deltaclo/SHT85-LOCIE/README.md

# SHT85-LOCIE
 
Acquisition cards for 16 SHT85 sensors.

Seiral Commands :

    READ?
    CONFIG?
    STATUS?
    *RST
    SET SHT1=
    SET SHT2=
    SET SHT3=
    SET SHT4=
    SET SHT5=
    SET SHT6=
    SET SHT7=
    SET SHT8=
    SET SHT9=
    SET SHT10=
    SET SHT11=
    SET SHT12=
    SET SHT13=
    SET SHT14=
    SET SHT15=
    SET SHT16=
    SET READ=
    SET MUX=
    SET BOXNAME=
    SET BOXIP=
    SET BOXGW=
    SET BOXMASK=
    SET BOXMAC=
    SET BOXNETWORK=
    GET SHT1
    GET SHT2
    GET SHT3
    GET SHT4
    GET SHT5
    GET SHT6
    GET SHT7
    GET SHT8
    GET SHT9
    GET SHT10
    GET SHT11
    GET SHT12
    GET SHT13
    GET SHT14
    GET SHT15
    GET SHT16
    GET READ
    GET MUX
    GET BOXNAME
    GET BOXIP
    GET BOXGW
    GET BOXMASK
    GET BOXMAC
    GET BOXNETWORK

  TCP/IP Commands:
  
    GET /config
    GET /read
    GET /status
    GET /rst
