deltaclo/SHT85-LOCIE/Documentation/images/ESP32-SHT85 3D - TF.png

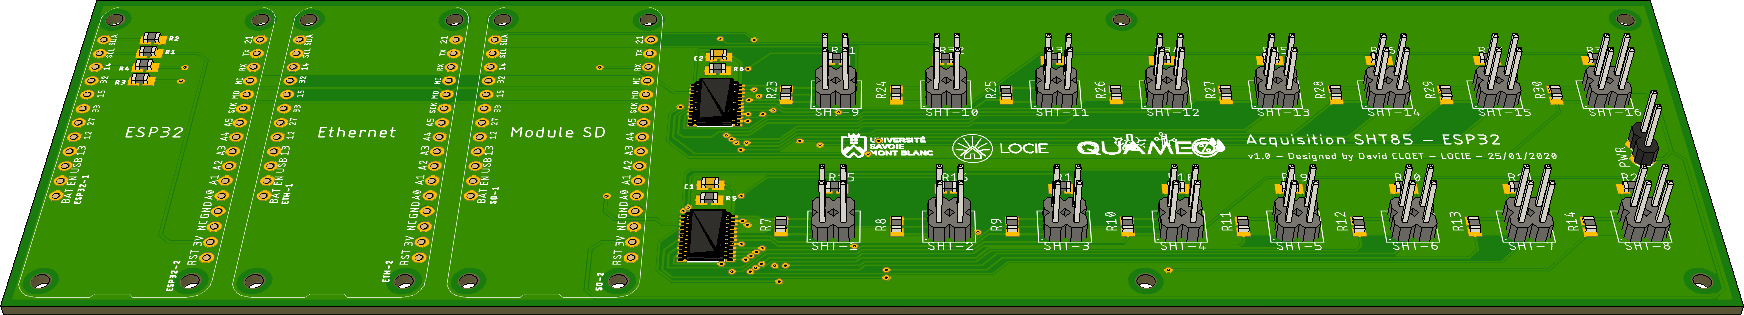
Documentation/images/ESP32-SHT85 3D - TF.png
