deltaclo/SHT85-LOCIE/PCB/ESP32_SHT85/sch/ESP32-SHT85_Page_1.png

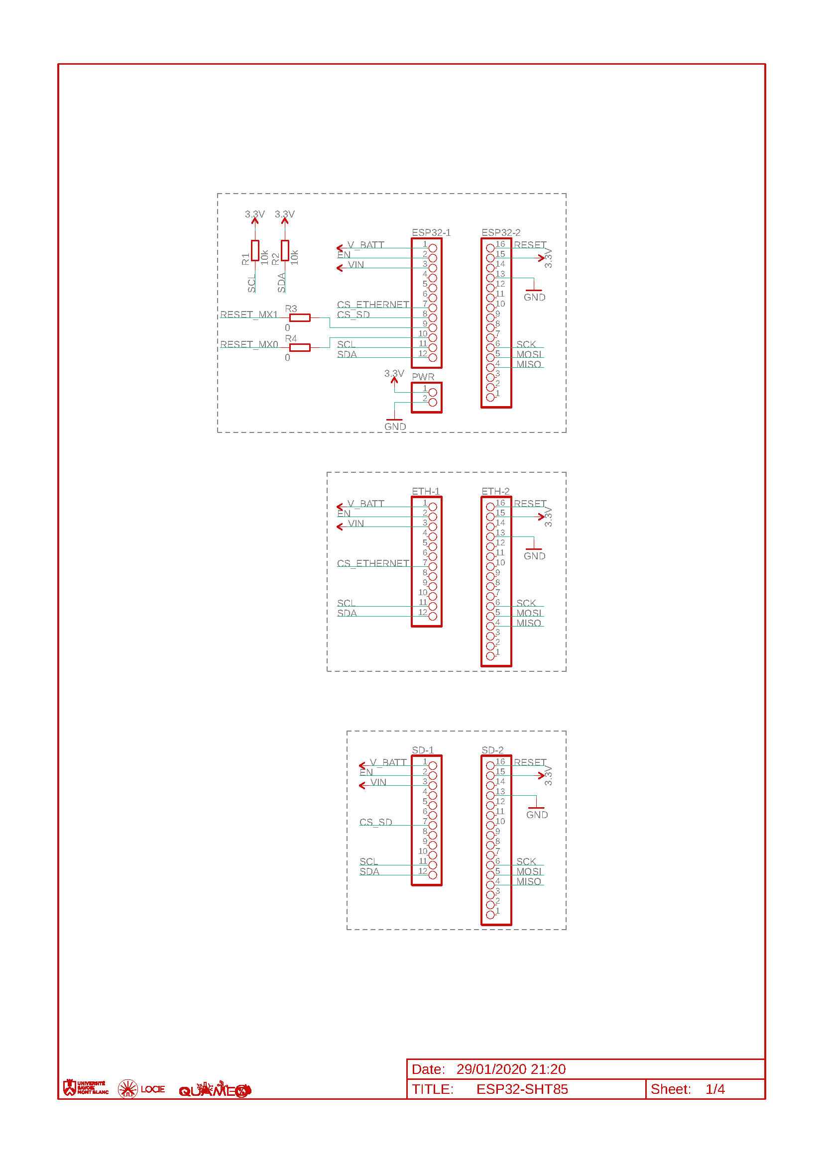
PCB/ESP32_SHT85/sch/ESP32-SHT85_Page_1.png
