deltaclo/SHT85-LOCIE/Documentation/ESP32-SHT85_BOM.xlsx

Sheet: BOM
Qty | Value | Device | Package | Fabricant | Parts | Description | Mouser | RS | Digikey | Farnell | Adafruit | Gotronic
1 | Adafruit 3405 | Adafruit 3405 | Feather Board | Adafruit | ESP32-1, ESP32-2 | Outils de développement Wi-Fi (802.11) HUZZAH32 - ESP32 Feather Board | Disponible | Non Disponible | Non Disponible | Non Disponible | Disponible | Disponible
1 | Adafruit 3201 | Adafruit 3201 | Feather Board | Adafruit | ETHER-1, ETHER-2 | Outils de développement Ethernet Ethernet FeatherWing | Disponible | Non Disponible | Disponible | Non Disponible | Disponible | Disponible
1 | Adafruit 2922 | Adafruit 2922 | Feather Board | Adafruit | SD-1, SD-2 | Accessoires Adafruit Adalogger FeatherWing - RTC + SD Add-on For All Feather Boards | Disponible | Disponible | Disponible | Non Disponible | Disponible | Disponible
2 | TCA9548APWR | TCA9548APWR | TSSOP24 | Texas Instruments | U1, U2 | CI commutateur - Divers 8-Channel I2C Switch | Disponible | Non Disponible | Disponible | Disponible | Non Disponible | Non Disponible
2 | 0 | MCU08050Z0000ZP500 | R0805 | Vishay | R3, R4 | Résistances à couches minces - CMS Zero ohm Jumper | Disponible | Disponible | Disponible | Disponible | Non Disponible | Non Disponible
36 | 10k | TNPW080510K0BEEA | R0805 | Vishay | R1, R2, R5, R6, R7, R8, R9, R10, R11, R12, R13, R14, R15, R16, R17, R18, R19, R20, R21, R22, R23, R24, R25, R26, R27, R28, R29, R30, R31, R32, R33, R34, R35, R36, R37, R38 | Résistances à couches minces - CMS 10Kohms .1% 25ppm | Disponible | Disponible | Disponible | Disponible | Non Disponible | Non Disponible
2 | 10uF | VJ0805G106KXYTW1BC | C0805 | Vishay | C1, C2 | Condensateurs céramique multicouches MLCC - CMS 10uF 6.3volts 10% | Disponible | Disponible | Disponible | Disponible | Non Disponible | Non Disponible
16 | SHT85_2X02PINHEAD | TSW-102-07-T-D | 2X02 | Samtec | SHT-1, SHT-2, SHT-3, SHT-4, SHT-5, SHT-6, SHT-7, SHT-8, SHT-9, SHT-10, SHT-11, SHT-12, SHT-13, SHT-14, SHT-15, SHT-16 | CONN HEADER VERT 4POS 2.54MM | Disponible | Disponible | Disponible | Disponible | Non Disponible | Non Disponible
1 | PINHD-1X2 | PINHD-1X2 | 1X02 | Samtec | PWR | CONN HEADER VERT 2POS 2.54MM | Disponible | Disponible | Disponible | Disponible | Disponible | Disponible

Sheet: MOUSER
N° MOUSER | N° de fab. | Fabricant | Description | Qté. | Prix (EUR) | Ext. : (EUR)
485-3405 | 3405 | Adafruit | Outils de développement Wi-Fi (802.11) HUZZAH32 - ESP32 Feather Board | 1 | 17.96 € | 17.96 €
485-3201 | 3201 | Adafruit | Outils de développement Ethernet Ethernet FeatherWing | 1 | 17.96 € | 17.96 €
485-2922 | 2922 | Adafruit | Accessoires Adafruit Adalogger FeatherWing - RTC + SD Add-on For All Feather Boards | 1 | 8.06 € | 8.06 €
595-TCA9548APWR | TCA9548APWR | Texas Instruments | CI commutateur - Divers 8-Channel I2C Switch | 2 | 1.36 € | 2.72 €
594-MCU08050Z0000ZP5 | MCU08050Z0000ZP500 | Vishay | Résistances à couches minces - CMS Zero ohm Jumper | 2 | 0.20 € | 0.40 €
71-TNPW080510K0BEEA | TNPW080510K0BEEA | Vishay | Résistances à couches minces - CMS 10Kohms .1% 25ppm | 36 | 0.47 € | 16.85 €
77-VJ805G106KXYTW1BC | VJ0805G106KXYTW1BC | Vishay | Condensateurs céramique multicouches MLCC - CMS 10uF 6.3volts 10% | 2 | 0.27 € | 0.54 €
200-TSW10207TD | TSW-102-07-T-D | Samtec | Embases et logements de câbles .100" Terminal Strip | 16 | 0.20 € | 3.26 €
200-TSW10207TS | TSW-102-07-T-S | Samtec | Embases et logements de câbles .100" Terminal Strip | 1 | 0.12 € | 0.12 €
 |  |  |  |  | Total des articles : | 67.87 €

Sheet: RS
N° RS | N° de fab. | Fabricant | Description | Qté. | Prix (EUR) | Ext. : (EUR)
 | 3405 | Adafruit | Outils de développement Wi-Fi (802.11) HUZZAH32 - ESP32 Feather Board | 1 |  | 0.00 €
 | 3201 | Adafruit | Outils de développement Ethernet Ethernet FeatherWing | 1 |  | 0.00 €
124-5518 | 2922 | Adafruit | Accessoires Adafruit Adalogger FeatherWing - RTC + SD Add-on For All Feather Boards | 1 | 8.12 | 8.12 €
 | TCA9548APWR | Texas Instruments | CI commutateur - Divers 8-Channel I2C Switch | 2 |  | 0.00 €
188-5952 | MCU08050Z0000ZP500 | Vishay | Résistances à couches minces - CMS Zero ohm Jumper | 2 | 0.065 | 0.13 €
818-3131 | PATT0805E1002BGT5 | Vishay | Résistances à couches minces - CMS 10Kohms .1% 25ppm | 36 | 0.98 € | 35.21 €
172-1528 | JMK212ABJ106KD-T | Taiyo Yuden | Condensateurs céramique multicouches MLCC - CMS 10uF 6.3volts 10% | 2 | 0.059 | 0.12 €
155-8161 | TSW-102-07-T-D | Samtec | Embases et logements de câbles .100" Terminal Strip | 16 | 0.198 | 3.17 €
155-8169 | TSW-102-07-T-S | Samtec | Embases et logements de câbles .100" Terminal Strip | 1 | 0.10 € | 0.10 €
 |  |  |  |  | Total des articles : | 46.74 €

Sheet: DIGIKEY
N° DIGIKEY | N° de fab. | Fabricant | Description | Qté. | Prix (EUR) | Ext. : (EUR)
 | 3405 | Adafruit | Outils de développement Wi-Fi (802.11) HUZZAH32 - ESP32 Feather Board | 1 |  | 0.00 €
1528-1725-ND | 3201 | Adafruit | Outils de développement Ethernet Ethernet FeatherWing | 1 | 17.74 | 17.74 €
1528-1621-ND | 2922 | Adafruit | Accessoires Adafruit Adalogger FeatherWing - RTC + SD Add-on For All Feather Boards | 1 | 7.96 | 7.96 €
296-34905-1-ND | TCA9548APWR | Texas Instruments | CI commutateur - Divers 8-Channel I2C Switch | 2 | 1.33 | 2.66 €
MCU0805-0.0-ZZCT-ND | MCU08050Z0000ZP500 | Vishay | Résistances à couches minces - CMS Zero ohm Jumper | 2 | 0.38 | 0.76 €
TNP10.0KABCT-ND | TNPW080510K0BEEA | Vishay | Résistances à couches minces - CMS 10Kohms .1% 25ppm | 36 | 0.44 € | 15.91 €
720-1854-1-ND | VJ0805G106KXYTW1BC | Taiyo Yuden | Condensateurs céramique multicouches MLCC - CMS 10uF 6.3volts 10% | 2 | 0.25 | 0.50 €
SAM1034-02-ND | TSW-102-07-T-D | Samtec | Embases et logements de câbles .100" Terminal Strip | 16 | 0.23 | 3.68 €
SAM1035-02-ND | TSW-102-07-T-S | Samtec | Embases et logements de câbles .100" Terminal Strip | 1 | 0.16 € | 0.16 €
 |  |  |  |  | Total des articles : | 49.37 €

Sheet: FARNELL
N° FARNELL | N° de fab. | Fabricant | Description | Qté. | Prix (EUR) | Ext. : (EUR)
 | 3405 | Adafruit | Outils de développement Wi-Fi (802.11) HUZZAH32 - ESP32 Feather Board | 1 |  | 0.00 €
 | 3201 | Adafruit | Outils de développement Ethernet Ethernet FeatherWing | 1 |  | 0.00 €
 | 2922 | Adafruit | Accessoires Adafruit Adalogger FeatherWing - RTC + SD Add-on For All Feather Boards | 1 |  | 0.00 €
3124884 | TCA9548APWR | TEXAS INSTRUMENTS | CI commutateur - Divers 8-Channel I2C Switch | 2 | 1.32 | 2.64 €
2614475 | MCU08050Z0000ZP500 | VISHAY | Résistances à couches minces - CMS Zero ohm Jumper | 2 | 0.178 | 0.36 €
1653329 | TNPW080510K0BEEA | VISHAY | Résistances à couches minces - CMS 10Kohms .1% 25ppm | 36 | 0.61 € | 21.96 €
9227814 | C0805C106K9PACTU | KEMET | Condensateurs céramique multicouches MLCC - CMS 10uF 6.3volts 10% | 2 | 0.171 | 0.34 €
2984553 | TSW-102-07-T-D | SAMTEC | Embases et logements de câbles .100" Terminal Strip | 16 | 0.173 | 2.77 €
2505046 | TSW-102-07-T-S | Samtec | Embases et logements de câbles .100" Terminal Strip | 1 | 0.08 € | 0.08 €
 |  |  |  |  | Total des articles : | 28.15 €
