deltaclo/SHT85-LOCIE/Documentation/Panier/ESP32-SHT85_BOM_Farnell.xls

Line Number | Order Code | Manufacturer Name | Manufacturer Part Number | Description | Price | Availability | Quantity
1 | Adafruit 3405 |  |  | Outils de développement Wi-Fi (802.11) HUZZAH32 - ESP32 Feather Board
2 | Adafruit 3201 |  |  | Outils de développement Ethernet Ethernet FeatherWing
3 | Adafruit 2922 |  |  | Accessoires Adafruit Adalogger FeatherWing - RTC + SD Add-on For All Feather Boards
4 | 3124884 | TEXAS INSTRUMENTS | TCA9548APWR | TCA9548APWR-Interface spécialisée, I2C, SM Bus | 1+ €1.32 25+ €1.16 50+ €1.04 100+ €0.927 250+ €0.87 500+ €0.812 1000+ €0.626 2500+ €0.617 | 397 | 2
5 | 2614475 | VISHAY | MCU08050Z0000ZP500 | MCU08050Z0000ZP500-Résistance à puce CMS, 0805 [2012 Metric], 0 ohm, MCU 0805 Series, 150 V, Couche mince, 200 mW | 10+ €0.178 250+ €0.0925 1000+ €0.0705 5000+ €0.0553 10000+ €0.0545 20000+ €0.051 100000+ €0.0453 | 24258 | 2
6 | 1653329 | VISHAY | TNPW080510K0BEEA | TNPW080510K0BEEA-Résistance à puce CMS, Couche mince, 0805 [2012 Metric], 10 kohm, Série TNPW, 150 V, Couche mince | 10+ €0.61 100+ €0.308 500+ €0.244 1000+ €0.18 2500+ €0.178 5000+ €0.162 25000+ €0.16 | 11540 | 36
7 | 9227814 | KEMET | C0805C106K9PACTU | C0805C106K9PACTU-Condensateur céramique multicouche CMS, 10 µF, 6.3 V, 0805 [2012 Metric], ± 10%, X5R, Série C KEMET | 5+ €0.171 50+ €0.0939 250+ €0.0722 500+ €0.0626 1500+ €0.0458 | 15451 | 2
8 | 2984553 | SAMTEC | TSW-102-07-T-D | TSW-102-07-T-D-Connecteur carte-à-carte, 2.54 mm, 4 Contact(s), Embase, TSW Series, Traversant, 2 Rangée(s) | 10+ €0.173 100+ €0.15 500+ €0.143 1000+ €0.124 2500+ €0.112 5000+ €0.0991 | 532 | 16
