deltaclo/SHT85-LOCIE/Documentation/Panier/ESP32-SHT85_BOM_Mouser.xls

PANIER
Ceci n'est pas une facture
26-janv.-20 13:53:24
 | N° Mouser | N° de fab. | Fabricant | N° client | Description | RoHS | Cycle de vie | Qté. | Prix (EUR) | Ext. : (EUR)
1 | 71-TNPW080510K0BEEA | TNPW080510K0BEEA | Vishay |  | Résistances à couches minces - CMS 10Kohms .1% 25ppm | RoHS : conforme |  | 36 | 0,468 € | 16,85 €
2 | 485-3405 | 3405 | Adafruit |  | Outils de développement Wi-Fi (802.11) HUZZAH32 - ESP32 Feather Board | RoHS : conforme |  | 1 | 17,96 € | 17,96 €
3 | 485-3201 | 3201 | Adafruit |  | Outils de développement Ethernet Ethernet FeatherWing | RoHS : conforme |  | 1 | 17,96 € | 17,96 €
4 | 485-2922 | 2922 | Adafruit |  | Accessoires Adafruit Adalogger FeatherWing - RTC + SD Add-on For All Feather Boards | RoHS : conforme |  | 1 | 8,06 € | 8,06 €
5 | 200-TSW10207TD | TSW-102-07-T-D | Samtec |  | Embases et logements de câbles .100" Terminal Strip | RoHS : conforme | Nouveau chez Mouser | 16 | 0,204 € | 3,26 €
6 | 594-MCU08050Z0000ZP5 | MCU08050Z0000ZP500 | Vishay |  | Résistances à couches minces - CMS Zero ohm Jumper | RoHS : conforme |  | 2 | 0,198 € | 0,40 €
7 | 595-TCA9548APWR | TCA9548APWR | Texas Instruments |  | CI commutateur - Divers 8-Channel I2C Switch | RoHS : conforme |  | 2 | 1,36 € | 2,72 €
8 | 77-VJ805G106KXYTW1BC | VJ0805G106KXYTW1BC | Vishay |  | Condensateurs céramique multicouches MLCC - CMS 10uF 6.3volts 10% | RoHS : conforme | Nouveau chez Mouser | 2 | 0,27 € | 0,54 €
En soumettant votre commande, vous acceptez ces conditions. (https://www.mouser.fr/saleterms) |  |  |  |  |  |  |  |  | Total des articles : | 67,75 €
Les prix sont ceux de la date et de l'heure indiquées. |  |  |  |  |  |  |  |  | Frais d'expédition : | 0,00 €
