deltaclo/SHT85-LOCIE/PCB/ESP32_SHT85/JLCPCB/ESP32-SHT85.BOM.xls

Qty | Value | Device | Package | Parts | Description | Quoted LCSC Part Number
2 | TCA9548APWR | TCA9548A | TSSOP24 | U1, U2 | TCA9548A I2C Multiplexer | C130026
2 | 0 | R-EU_R0805 | R0805 | R3, R4 | RESISTOR, European symbol | C62818
36 | 10k | R-EU_R0805 | R0805 | R1, R2, R5, R6, R7, R8, R9, R10, R11, R12, R13, R14, R15, R16, R17, R18, R19, R20, R21, R22, R23, R24, R25, R26, R27, R28, R29, R30, R31, R32, R33, R34, R35, R36, R37, R38 | RESISTOR, European symbol | C17414
2 | 10uF | C-EUC0805 | C0805 | C1, C2 | CAPACITOR, European symbol | C15850
