deltaclo/SHT85-LOCIE/SW/ESP32_SHT85_LabVEW_Multi_Acquisition/log/PROJET_David-Test_2020-09-16_11-01-33.csv

Date / Heure | SHT 1-T | SHT 1-H | SHT 2-T | SHT 2-H | SHT 3-T | SHT 3-H | SHT 4-T | SHT 4-H | SHT 5-T | SHT 5-H | SHT 6-T | SHT 6-H | SHT 7-T | SHT 7-H | SHT 8-T | SHT 8-H | SHT 9-T | SHT 9-H | SHT 10-T | SHT 10-H | SHT 11-T | SHT 11-H | SHT 12-T | SHT 12-H | SHT 13-T | SHT 13-H | SHT 14-T | SHT 14-H | SHT 15-T | SHT 15-H | SHT 16-T | SHT 16-H
2020/09/16 11:01:33 | 24,640000 | 62,590000 | 24,810000 | 61,630000 | 24,810000 | 61,950000 | 25,000000 | 61,390000 | 24,960000 | 60,950000 | 25,020000 | 61,150000 | 24,410000 | 62,640000 | 25,480000 | 60,620000 | 24,670000 | 62,300000 | 24,900000 | 61,520000 | 24,900000 | 61,740000 | 25,170000 | 60,870000 | 25,200000 | 59,940000 | 25,230000 | 59,750000 | 24,520000 | 62,660000 | 25,800000 | 58,560000
2020/09/16 11:01:44 | 24,620000 | 62,540000 | 24,800000 | 61,510000 | 24,830000 | 62,000000 | 24,990000 | 61,330000 | 24,940000 | 60,980000 | 25,020000 | 61,120000 | 24,390000 | 62,650000 | 25,450000 | 60,610000 | 24,660000 | 62,300000 | 24,890000 | 61,540000 | 24,900000 | 61,690000 | 25,160000 | 60,890000 | 25,200000 | 59,940000 | 25,200000 | 59,660000 | 24,540000 | 62,720000 | 25,810000 | 58,550000
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
