deltaclo/SHT85-LOCIE/PCB/ESP32_SHT85/ESP32-SHT85.pdf

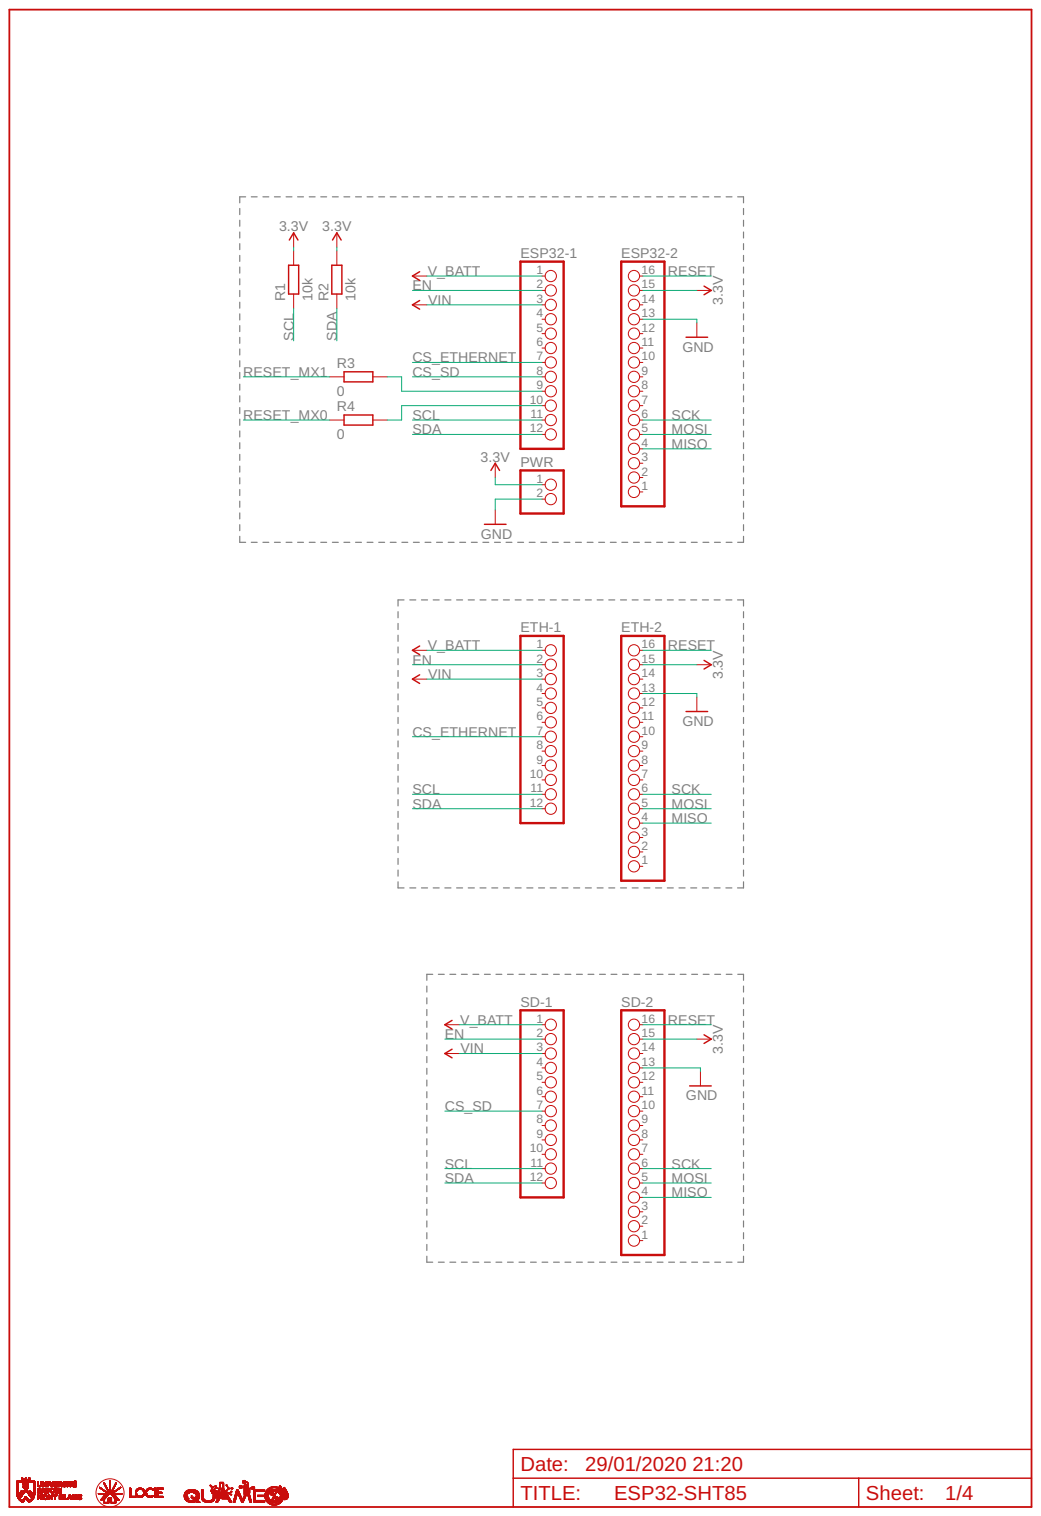
[picture p25: page 1]

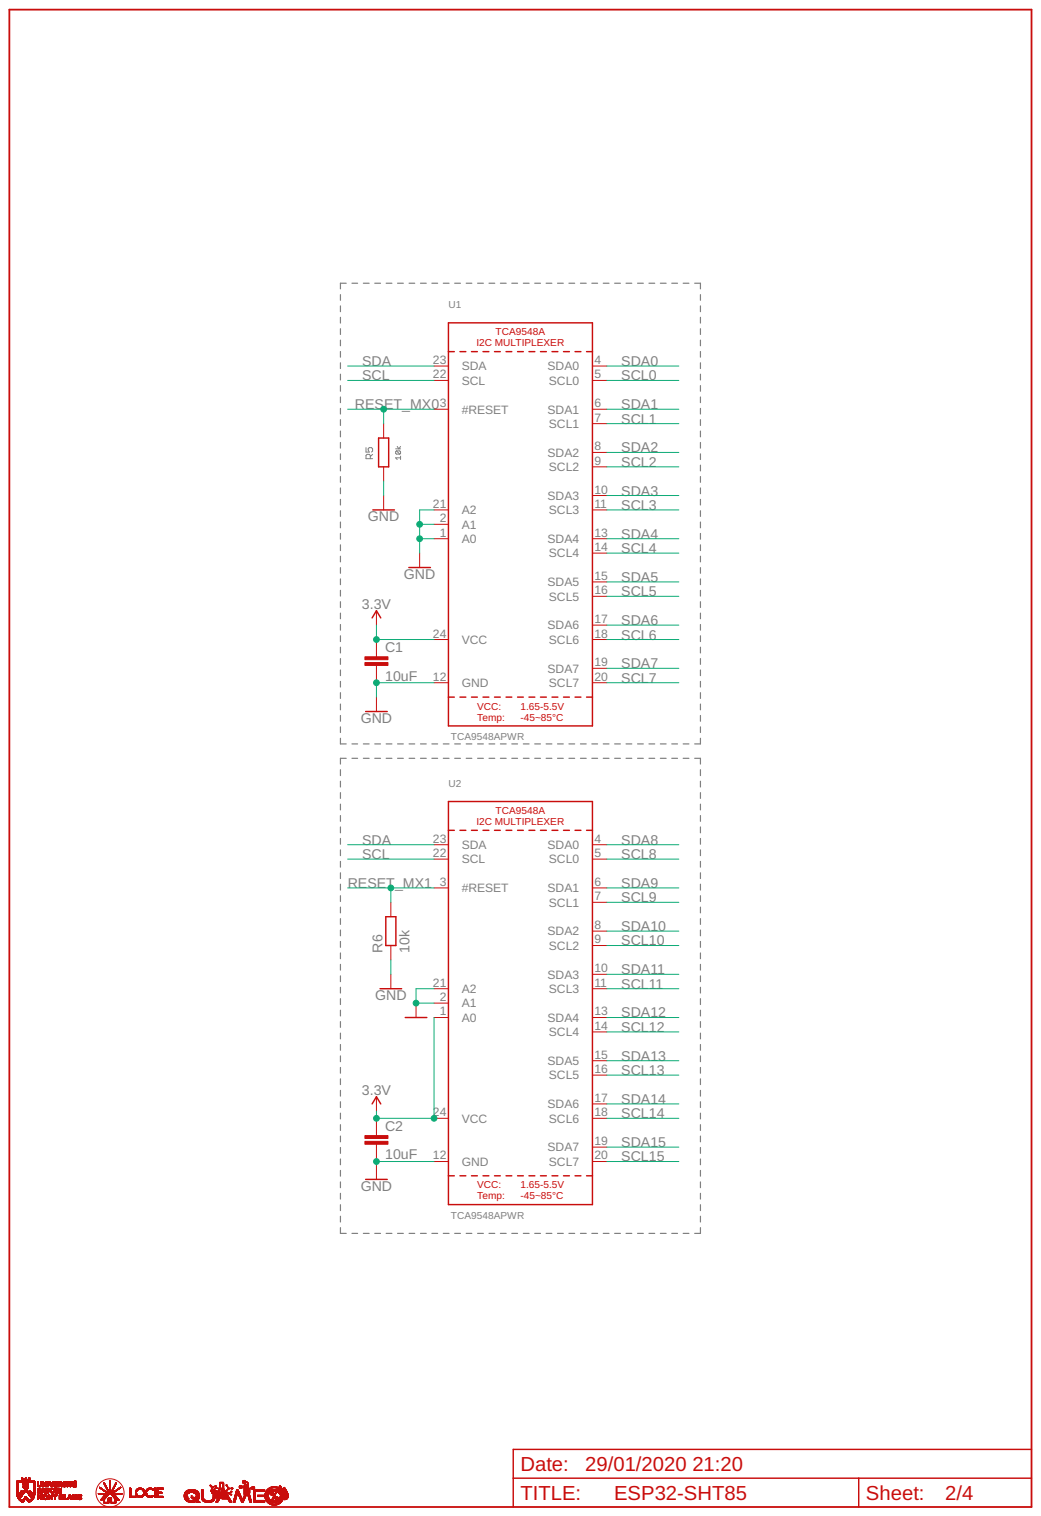
[picture p26: page 2]

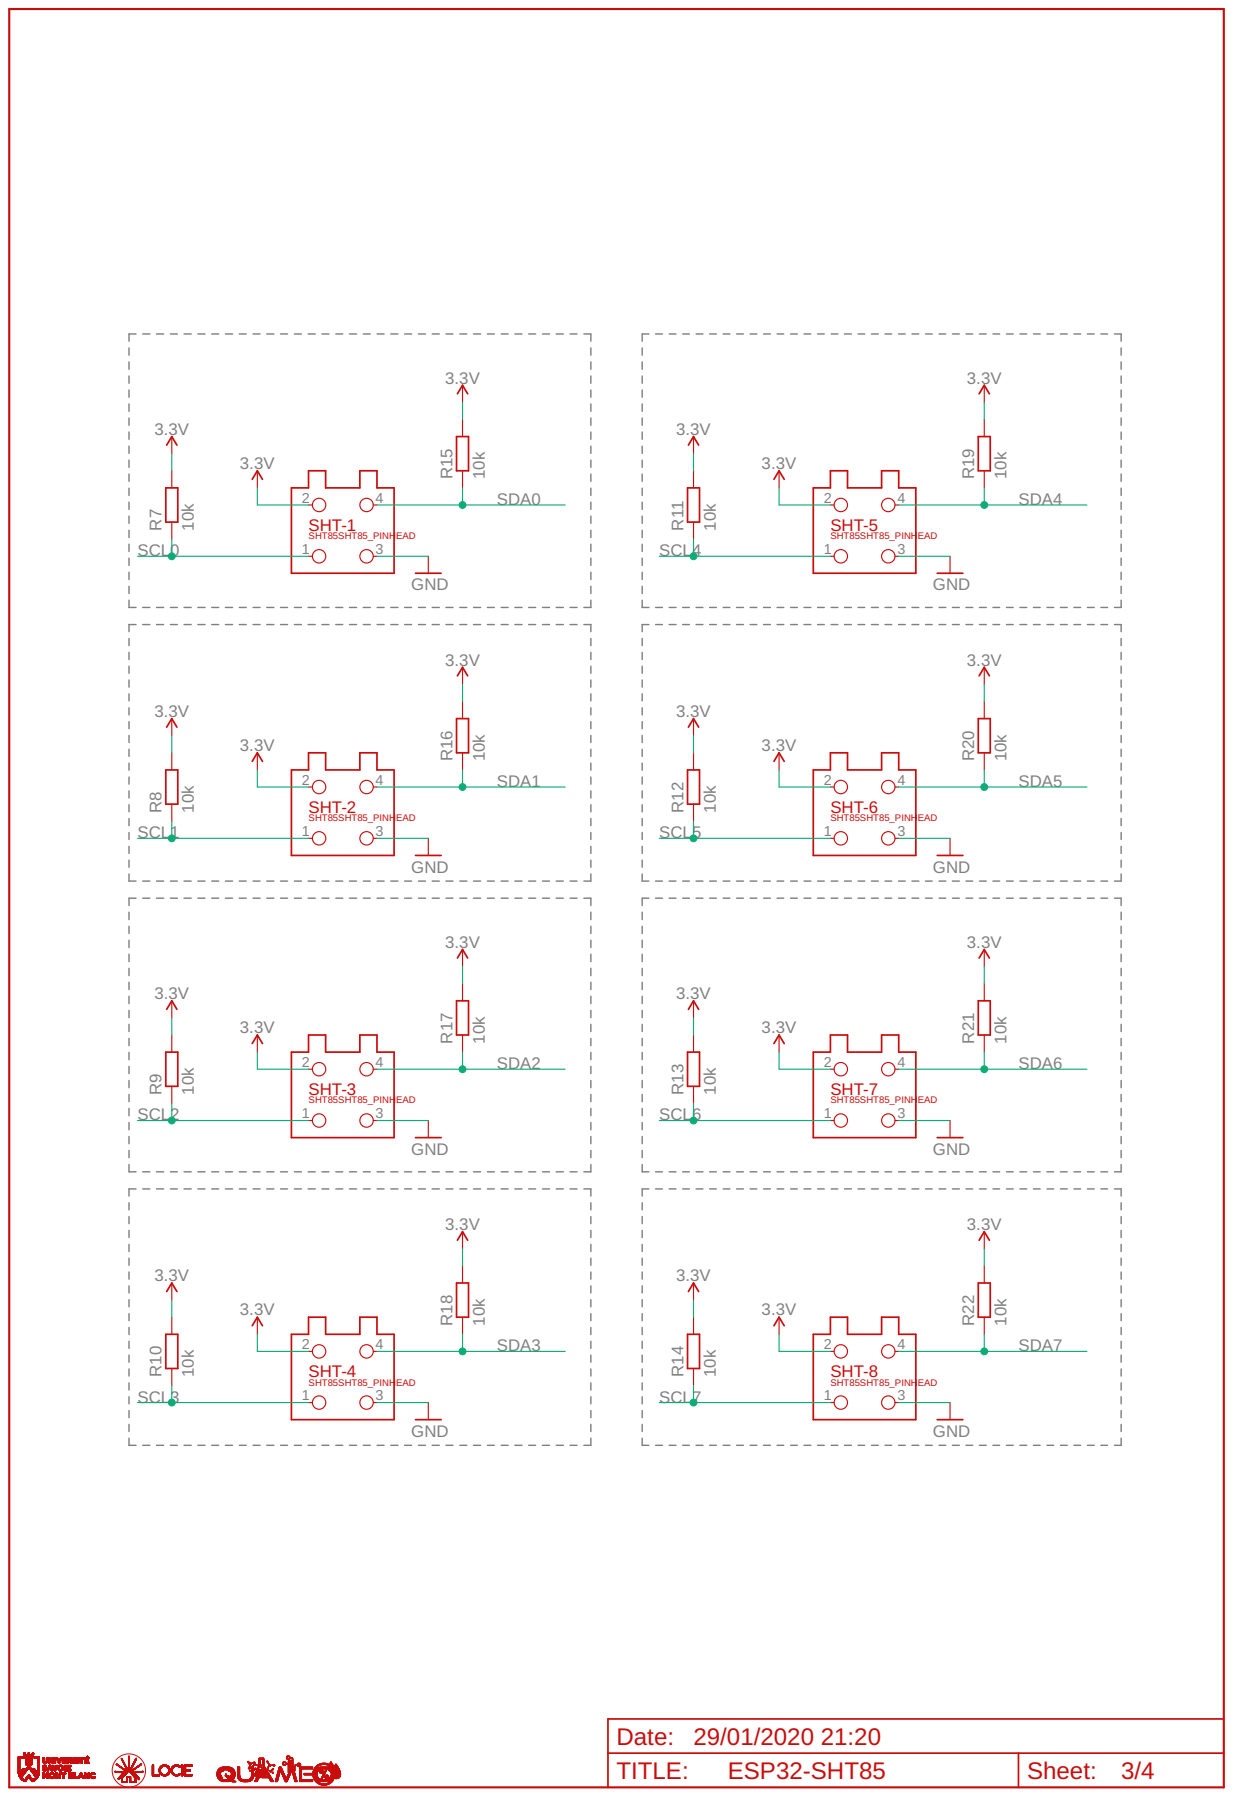
[picture p27: page 3]

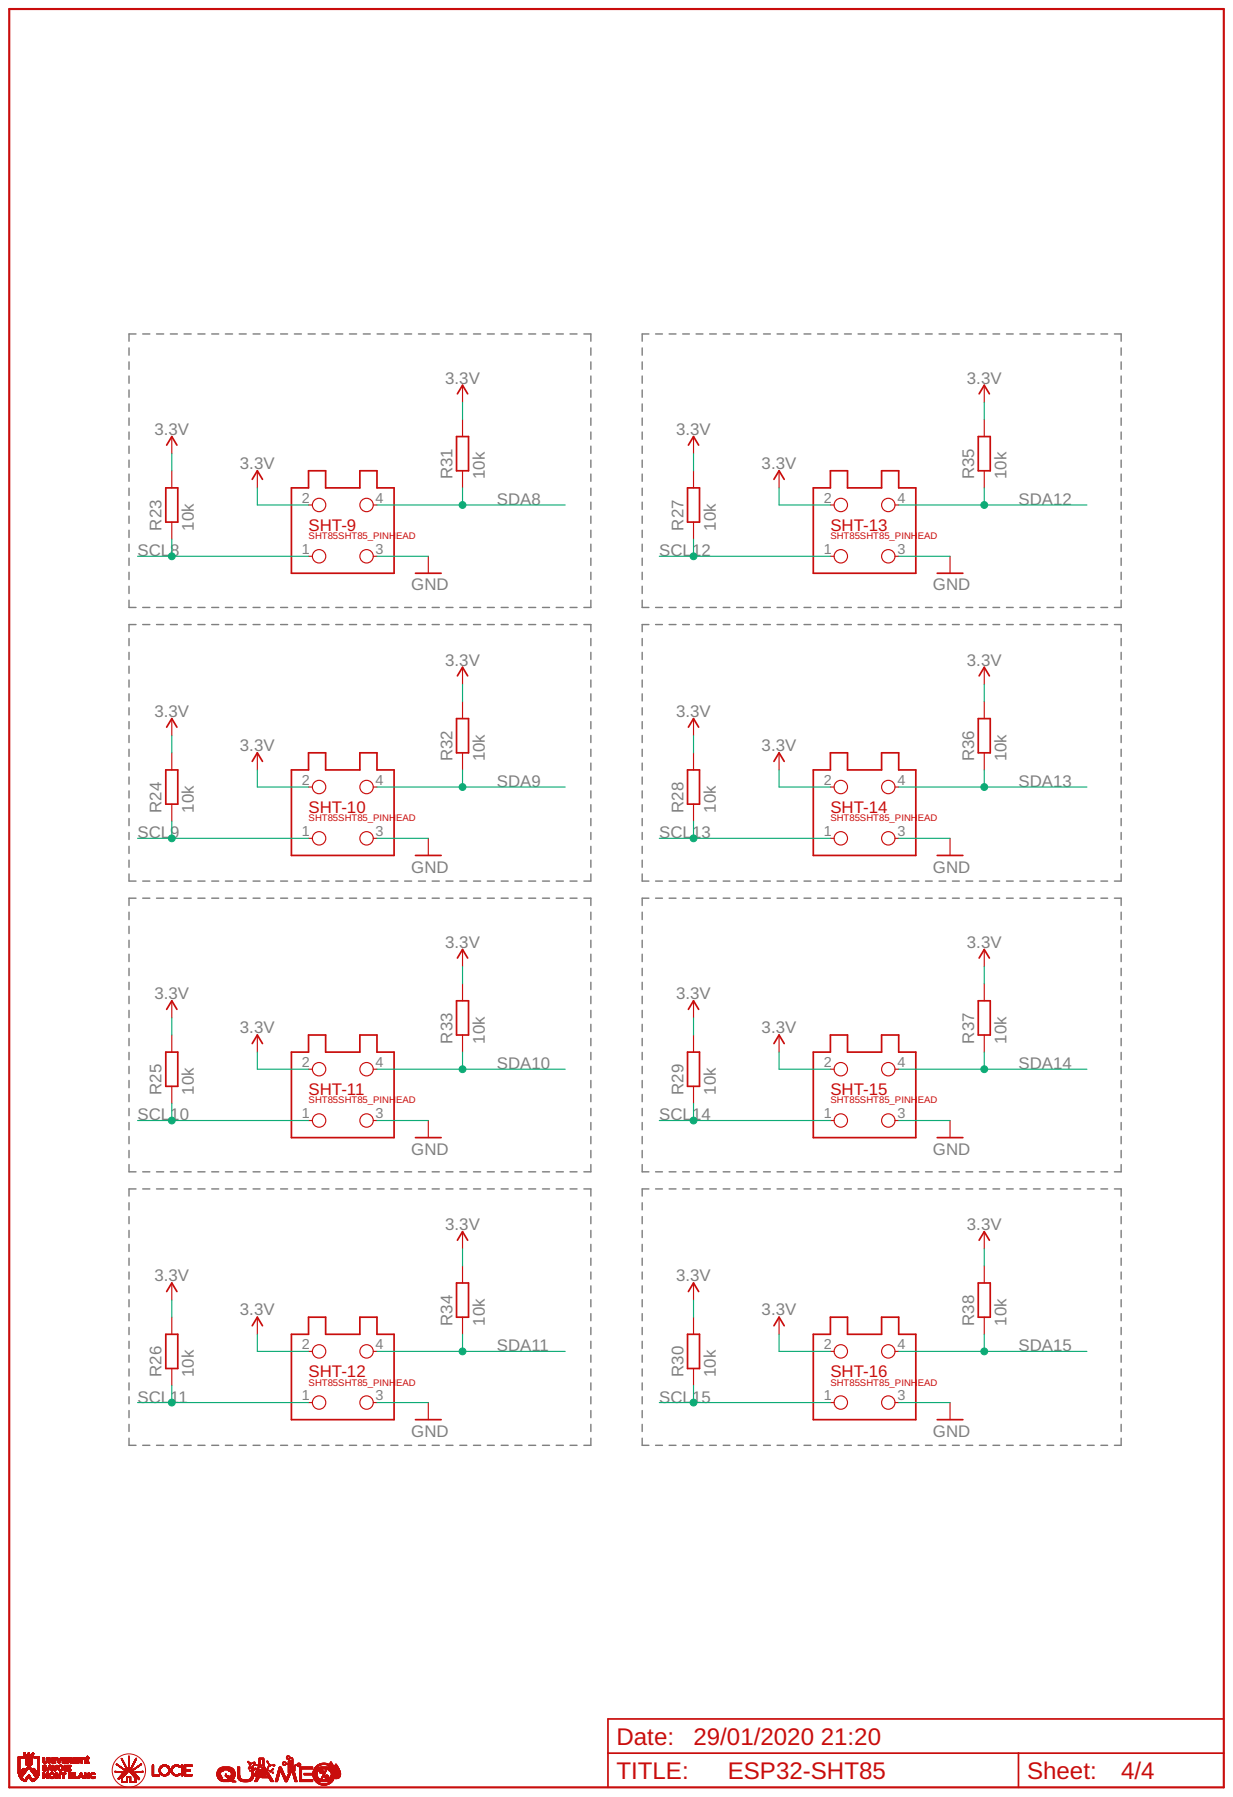
[picture p28: page 4]
