deltaclo/SHT85-LOCIE/(commit log)

2020-09-11 Eagle files
    [ESP32-SHT85.BOM.xls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]
2020-09-15 clean dir
    [ESP32-SHT85.BOM.xls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]
2020-09-16 compile CEA
    [configuration.cfg, etiquettes MAC CEA.xlsx, liste.csv]
2020-10-11 arduino lib
2020-11-12 fix bug
    [config.csv]
